ETML-ES-SLO/PRJ_2318_Metronome_Electronique/doc/Annexes/CDC/CDC - Interface Epaper.png

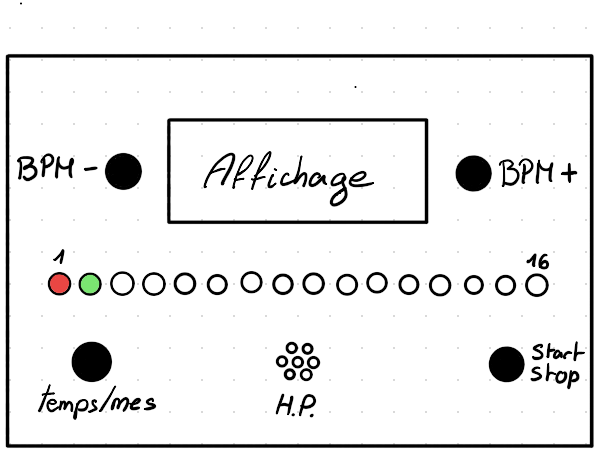
doc/Annexes/CDC/CDC - Interface Epaper.png
