ETML-ES-SLO/PRJ_2318_Metronome_Electronique/doc/Datasheets/Touchscreen Controller/adafruit_products_tsc2007Schem.png

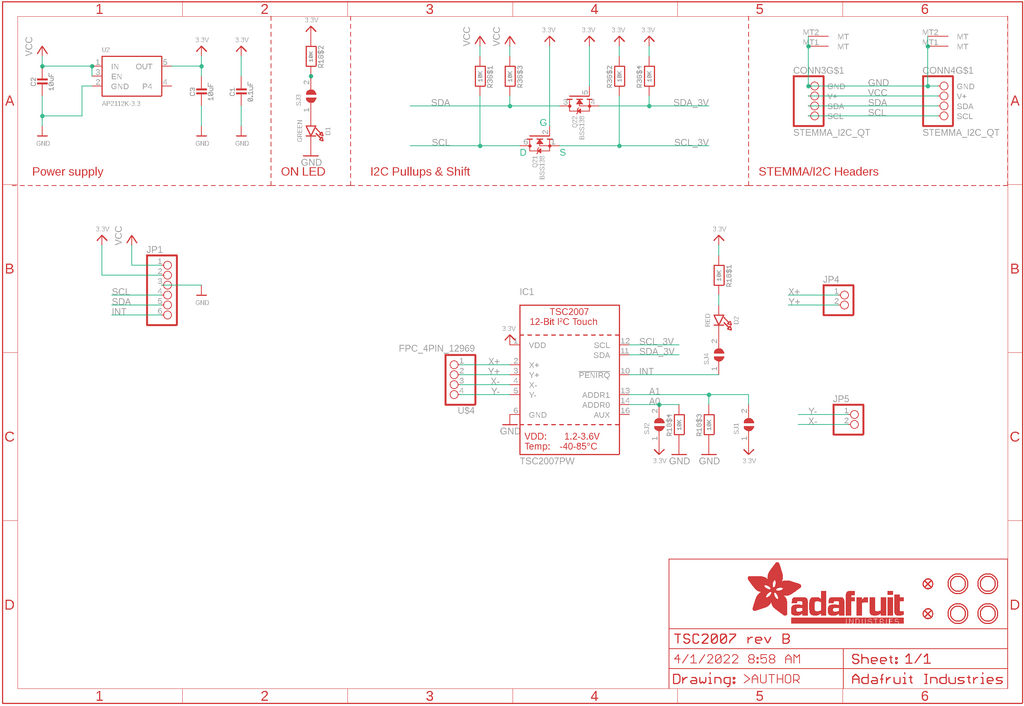
doc/Datasheets/Touchscreen Controller/adafruit_products_tsc2007Schem.png
