ETML-ES-SLO/PRJ_2318_Metronome_Electronique/hard/Images/adafruit_products_32schem.png

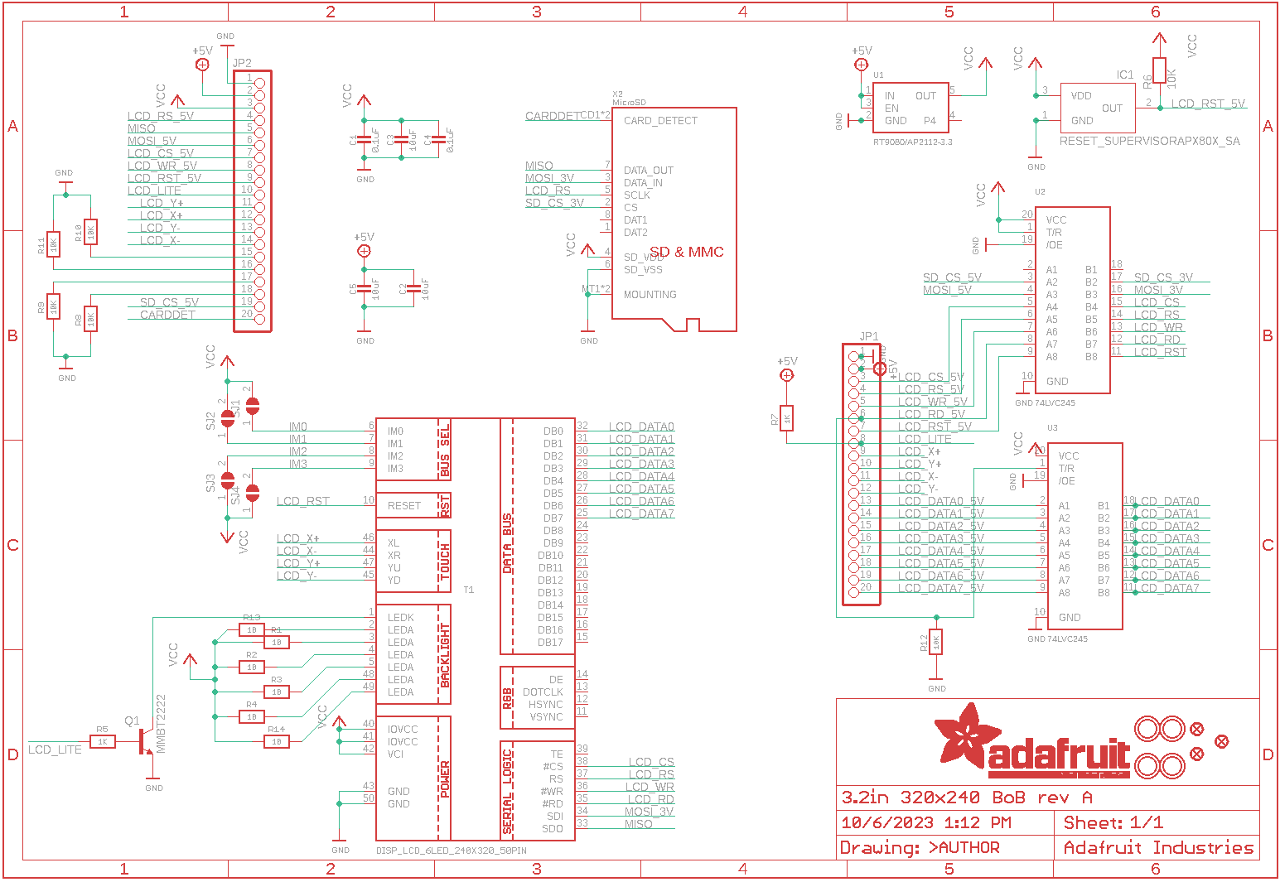
hard/Images/adafruit_products_32schem.png
