ETML-ES-SLO/PRJ_2318_Metronome_Electronique/hard/Imported Libraries/Microcontroller/AltiumDesigner/QFN44_8x8MC_MCH.step

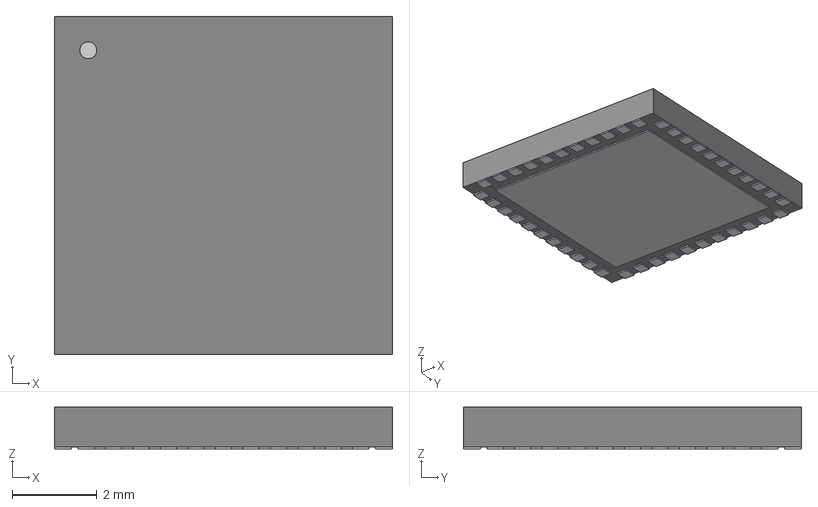
[picture p29: CAD file, 2024-05-31]
hard/Imported Libraries/Microcontroller/AltiumDesigner/QFN44_8x8MC_MCH.step
8.00 x 8.00 x 0.993 mm
