ETML-ES-SLO/PRJ_2318_Metronome_Electronique/(list of files, drawings)

Other design files:
hard/2318_Métronome_Electronique.PrjPcb
hard/2318_Métronome_Electronique_Library.PcbLib
hard/Alimentation.SchDoc
hard/General.SchDoc
hard/Imported Libraries/Adafruit Touch screen ILI9341/2478/2478.SchLib
hard/Imported Libraries/Adafruit Touch screen ILI9341/2478/ADAFRUIT_2478.PcbLib
hard/Imported Libraries/Haut Parleur/SMTB-0827-TW-R/SMTB-0827-TW-R.SchLib
hard/Imported Libraries/Haut Parleur/SMTB-0827-TW-R/XDCR_SMTB-0827-TW-R.PcbLib
hard/Imported Libraries/Microcontroller/AltiumDesigner/PIC32MX230F064D-IML.PcbLib
hard/Imported Libraries/Microcontroller/AltiumDesigner/PIC32MX230F064D-IML.SchLib
hard/Imported Libraries/Power Switch/PB400EEQR1BLK/PB400EEQR1BLK.SchLib
hard/Imported Libraries/Power Switch/PB400EEQR1BLK/SW_PB400EEQR1BLK.PcbLib
hard/Imported Libraries/Touchscreen controller TSC2007/TSC2007IPW/SOP65P640X120-16N.PcbLib
hard/Imported Libraries/Touchscreen controller TSC2007/TSC2007IPW/TSC2007IPW.SchLib
hard/Imported Libraries/USB-C/USB4105-GF-A/GCT_USB4105-GF-A.PcbLib
hard/Imported Libraries/USB-C/USB4105-GF-A/USB4105-GF-A.SchLib
hard/Microcontroleur.SchDoc
