ETML-ES-SLO/PRJ_2318_Metronome_Electronique/soft/MPLABX_PRJ/firmware/src/buzzer.c

/*******************************************************************************
  MPLAB Harmony Application Header File

  Company:
    ETML-ES

  File Name:
    buzzer.c

  Author:
    Julien Decrausaz
  
  Description:
    
*******************************************************************************/

//============================================================================//
//                                  INCLUDES                                  //
//============================================================================//

/* This section lists the other files that are included in this file.
 */

/* TODO:  Include other files here if needed. */






/* ************************************************************************** */




//============================================================================//
//                                   DEFINES                                  //
//============================================================================//
//#define PULSE_HIGH PLIB_PORTS_PinWrite(PORTS_ID_0,PORT_CHANNEL_C,PORTS_BIT_POS_7,true)


/* ************************************************************************** */

//============================================================================//
//                            LOCAL FUNCTIONS                                 //
//============================================================================//





/* ************************************************************************** */






//============================================================================//
//                            GLOBAL FUNCTIONS                                //
//============================================================================//




/* ************************************************************************** */






/* *****************************************************************************
 End of File
 */
